cdntinker/KiCAD_Customs/3D/AG9912-MTB.stp

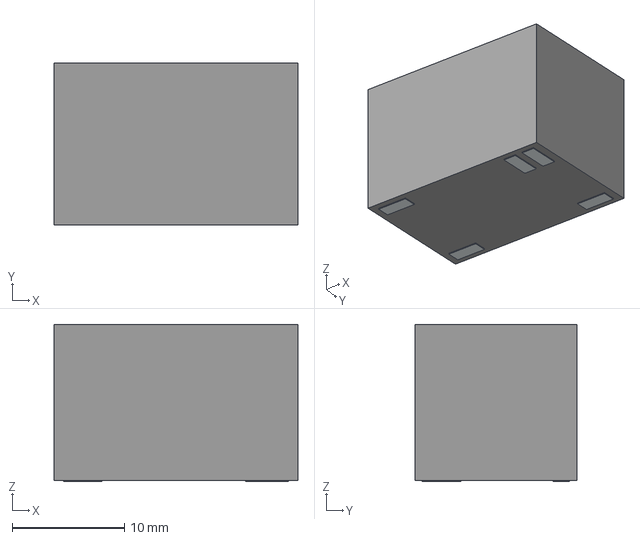
[picture p1: CAD file, 2023-11-06]
3D/AG9912-MTB.stp
21.7 x 14.4 x 14.0 mm
Pins
