cdntinker/KiCAD_Customs/3D/BM04B-SRSS-TB007_horizontal_qwiic.step

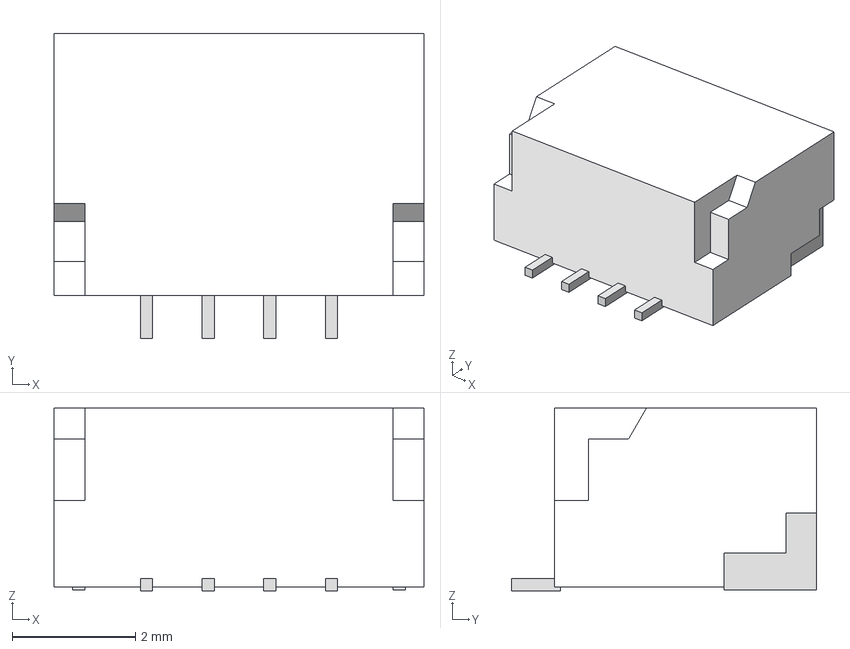
[picture p2: CAD file, 2023-11-06]
3D/BM04B-SRSS-TB007_horizontal_qwiic.step
6.00 x 4.95 x 2.96 mm
