cdntinker/KiCAD_Customs/3D/DMP3013SFV-7.stp

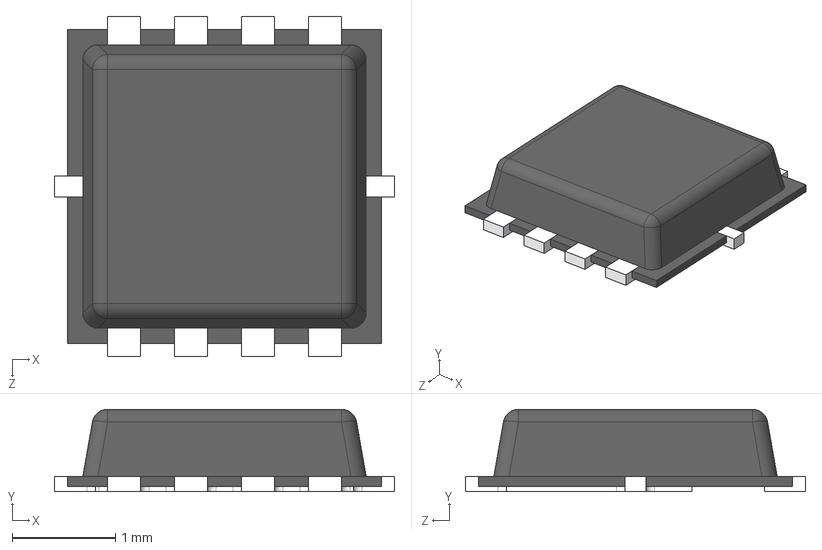
[picture p3: CAD file, 2023-11-06]
3D/DMP3013SFV-7.stp
3.30 x 0.8 x 3.30 mm
