cdntinker/KiCAD_Customs/3D/SCF4030-12-04.stp

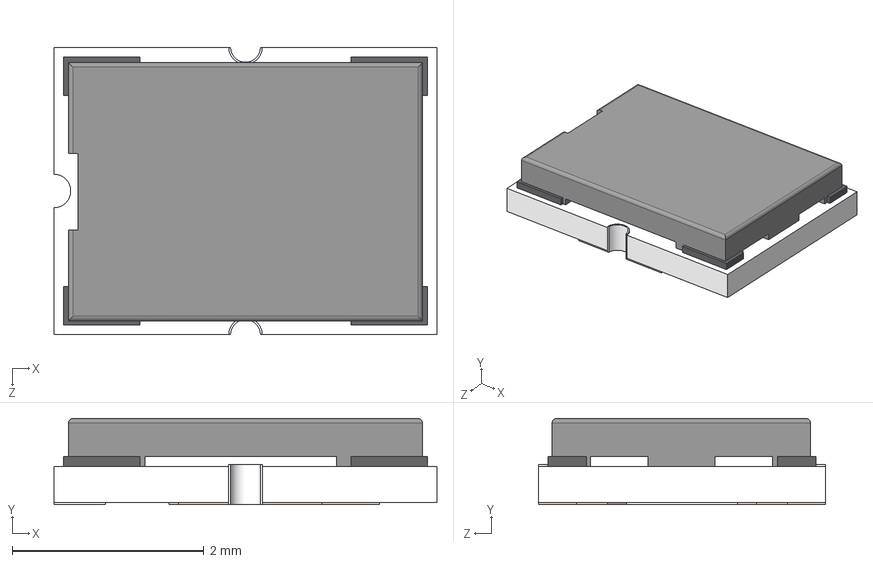
[picture p4: CAD file, 2023-11-06]
3D/SCF4030-12-04.stp
4.00 x 0.9 x 3.00 mm
奻裔
ｱｳｲｿｺｸﾅﾌ
價啣陔
籵謂1
ｱｳｲｿｺｸﾅﾌ2
籵謂2
左右电极背面 (2)
窪蝶1
窪蝶2
窪蝶3
窪蝶4
