cdntinker/KiCAD_Customs/3D/AT24C04D-MAHM-E.stp

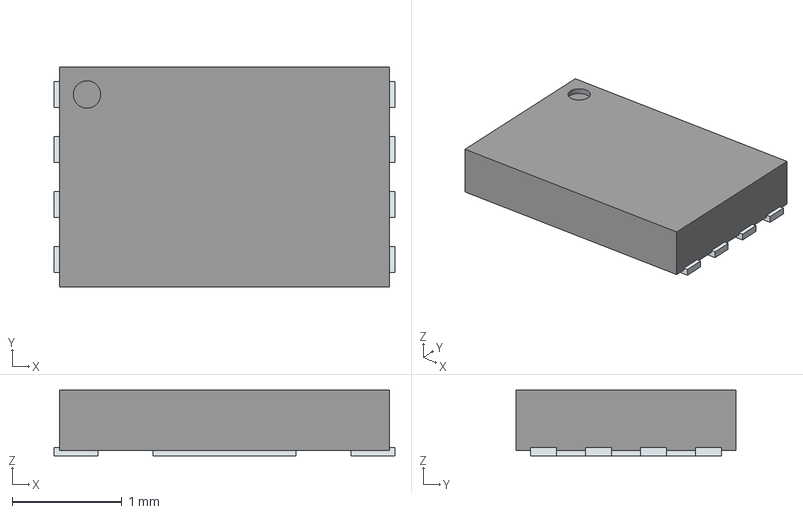
[picture p5: CAD file, 2023-11-06]
3D/AT24C04D-MAHM-E.stp
3.10 x 2.00 x 0.6 mm
ThermalPin
PinsArrayLR
