cdntinker/KiCAD_Customs/3D/USB4640-HZH-03.stp

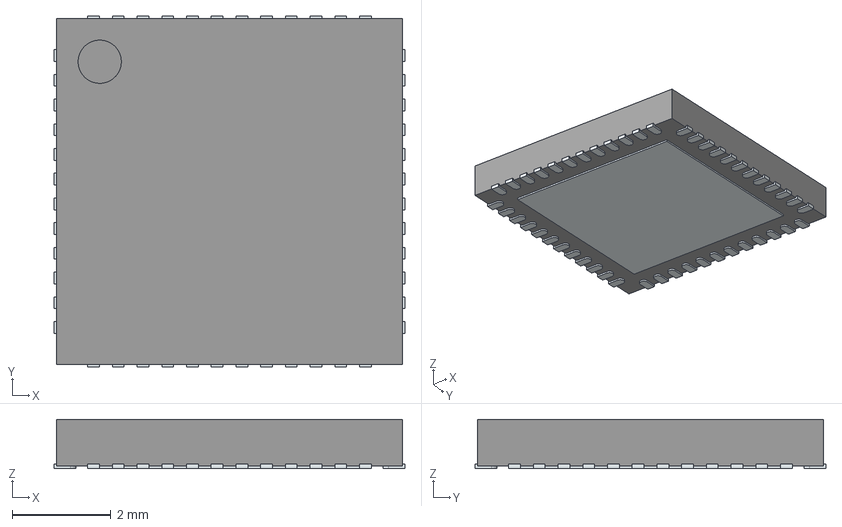
[picture p6: CAD file, 2023-11-06]
3D/USB4640-HZH-03.stp
7.10 x 7.10 x 1.00 mm
ThermalPin
PinsArrayLR
PinsArrayTB
