cdntinker/KiCAD_Customs/3D/1x2.STEP

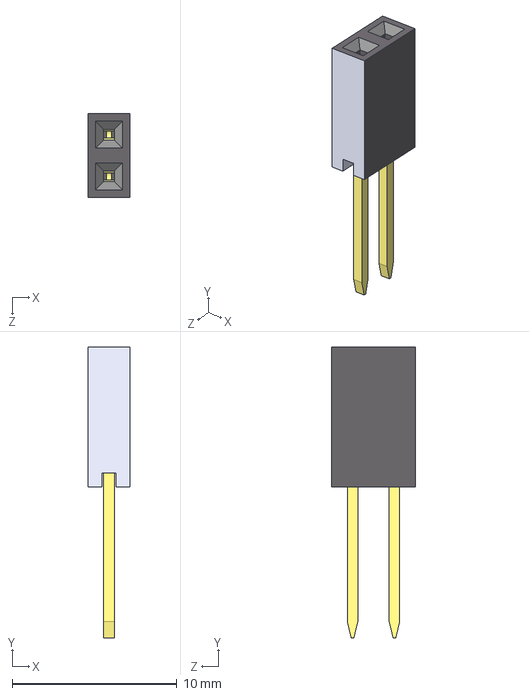
[picture p7: CAD file, 2023-11-06]
3D/1x2.STEP
2.54 x 17.6 x 5.08 mm
