cdntinker/KiCAD_Customs/3D/MicroSD_503398-1892.stp

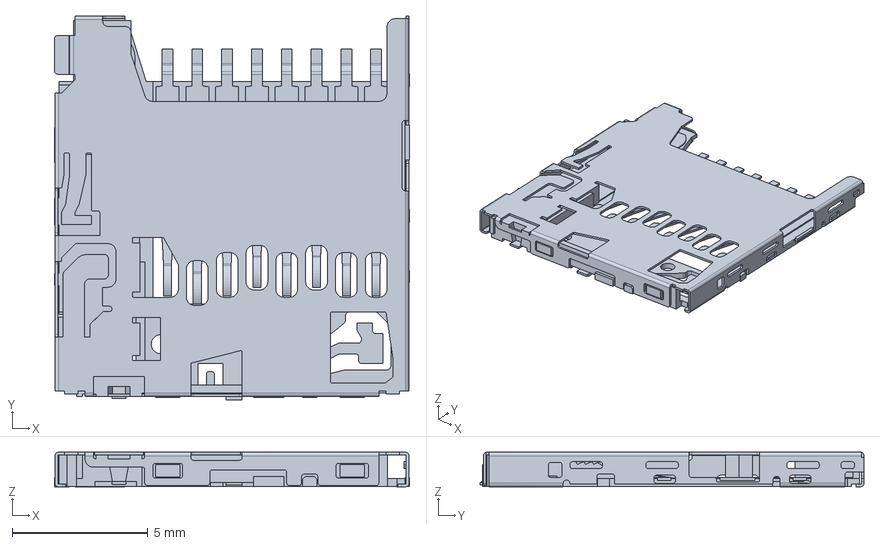
[picture p8: CAD file, 2023-11-06]
3D/MicroSD_503398-1892.stp
13.1 x 14.2 x 1.28 mm
