cdntinker/KiCAD_Customs/3D/SPM6530T-1R0M120.stp

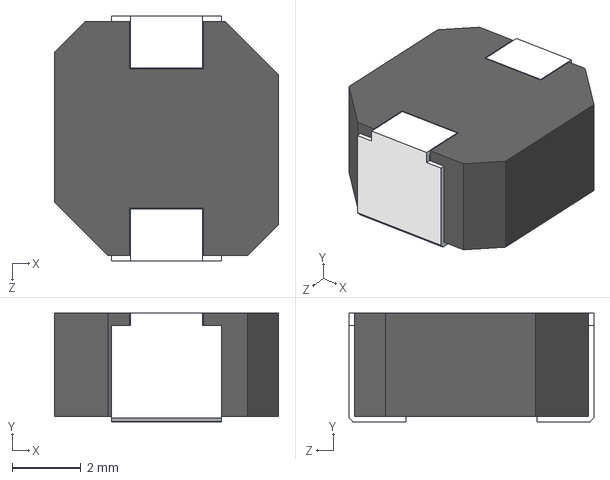
[picture p9: CAD file, 2023-11-06]
3D/SPM6530T-1R0M120.stp
6.50 x 3.15 x 7.10 mm
