cdntinker/KiCAD_Customs/3D/ARJM11D7114ABEW2.step

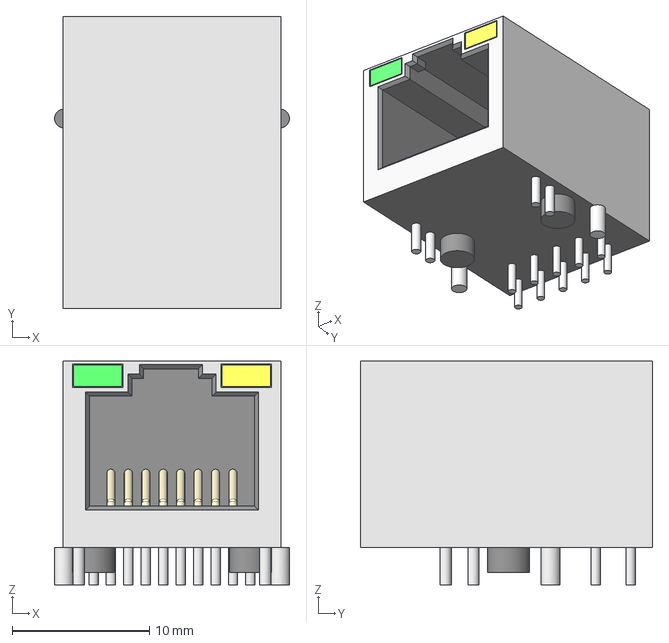
[picture p10: CAD file, 2023-11-06]
3D/ARJM11D7114ABEW2.step
17.1 x 21.3 x 16.3 mm
