cdntinker/KiCAD_Customs/3D/RQM0029A.stp

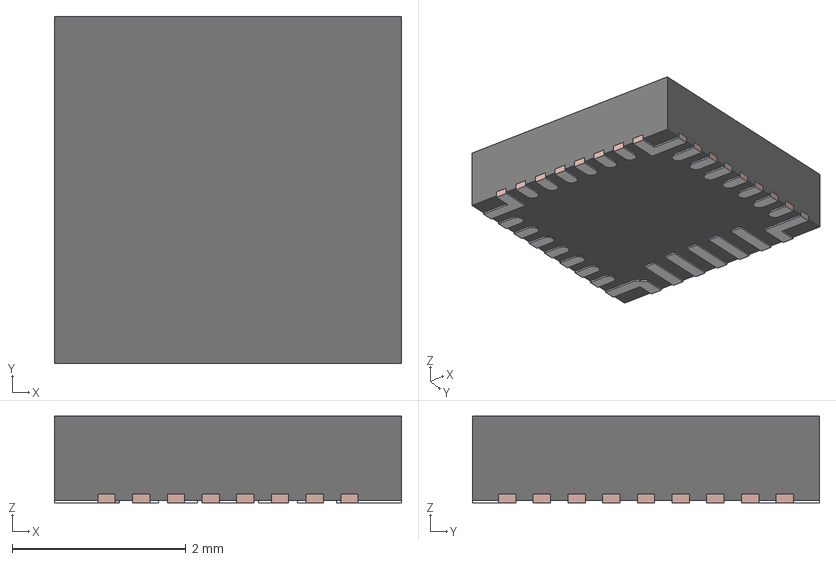
[picture p11: CAD file, 2023-11-06]
3D/RQM0029A.stp
4.00 x 4.00 x 1.00 mm
FRAME
MOLD
