cdntinker/KiCAD_Customs/3D/ABM8-26.000MHZ-10-1-U-T.STEP

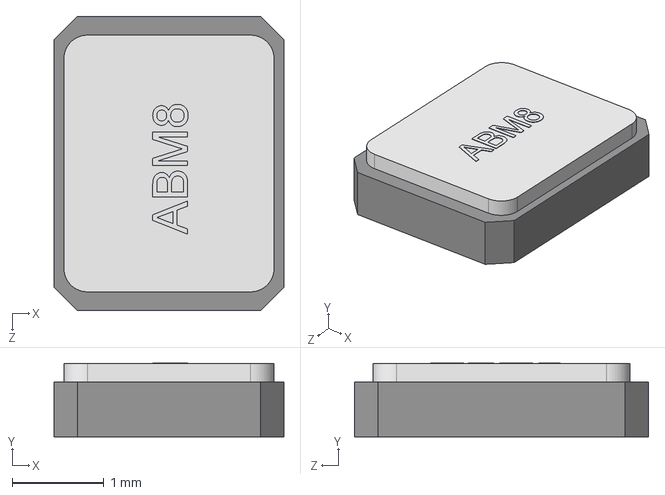
[picture p12: CAD file, 2023-11-06]
3D/ABM8-26.000MHZ-10-1-U-T.STEP
2.50 x 0.805 x 3.20 mm
