cdntinker/KiCAD_Customs/3D/QWIIC_Vertical-JST_SH_BM04B-SRSS-TB_1x04-1MP_P1.00mm_Vertical.step

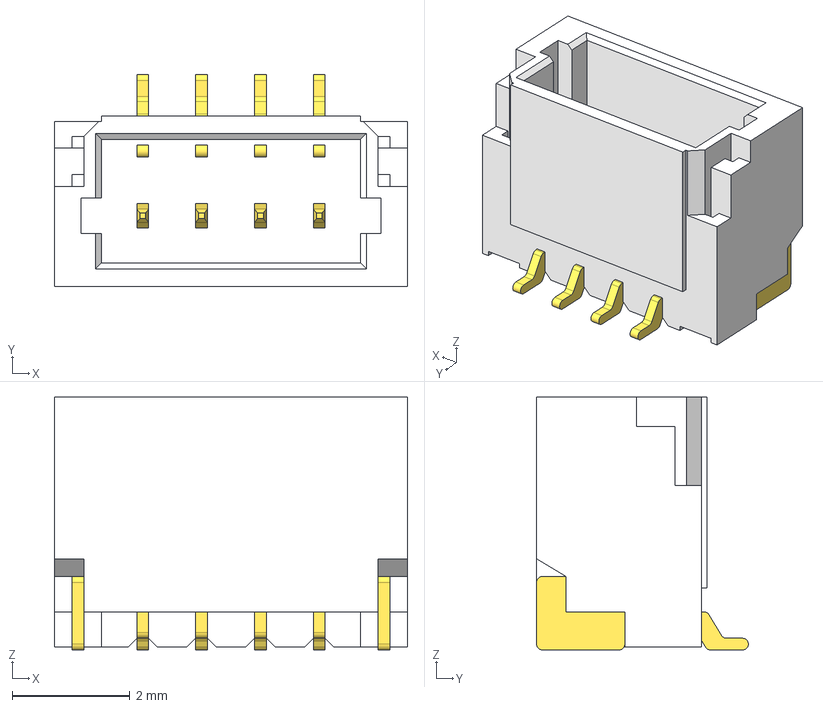
[picture p13: CAD file, 2023-11-06]
3D/QWIIC_Vertical-JST_SH_BM04B-SRSS-TB_1x04-1MP_P1.00mm_Vertical.step
6.00 x 3.60 x 4.30 mm
pin000
pin001
pin002
pin003
gnd000
gnd001
