cdntinker/KiCAD_Customs/3D/ESP8285.stp

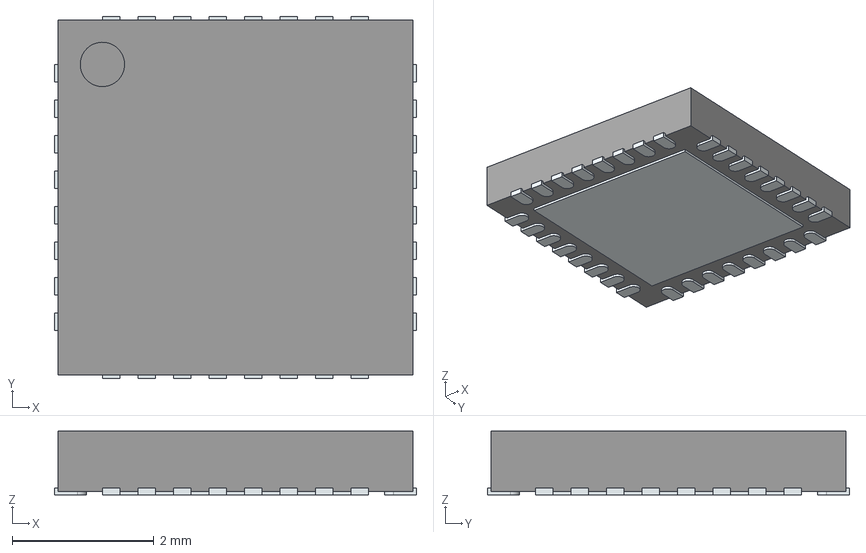
[picture p14: CAD file, 2023-11-06]
3D/ESP8285.stp
5.10 x 5.10 x 0.9 mm
ThermalPin
PinsArrayLR
PinsArrayTB
