cdntinker/KiCAD_Customs/3D/SISF06DN-T1-GE3.stp

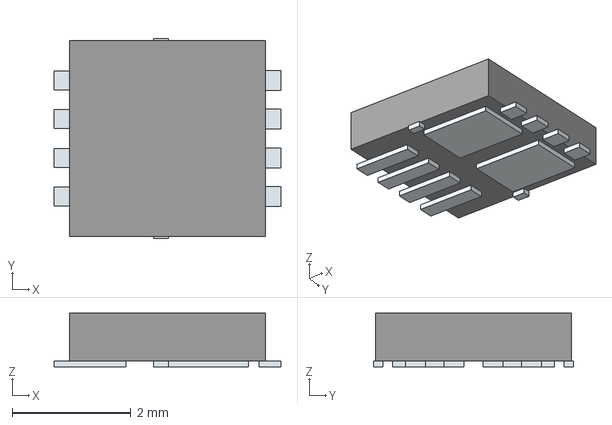
[picture p15: CAD file, 2023-11-06]
3D/SISF06DN-T1-GE3.stp
3.82 x 3.37 x 0.9 mm
Pins
