cdntinker/KiCAD_Customs/3D/Ag9912LP.stp

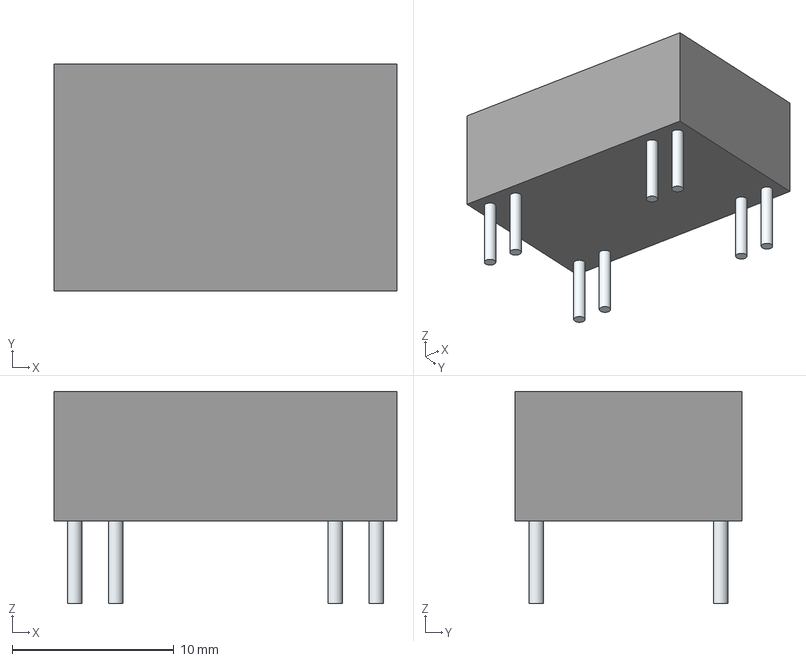
[picture p16: CAD file, 2023-11-06]
3D/Ag9912LP.stp
21.2 x 14.0 x 13.1 mm
Leads
