cdntinker/KiCAD_Customs/3D/XRCGB24_MUR.step

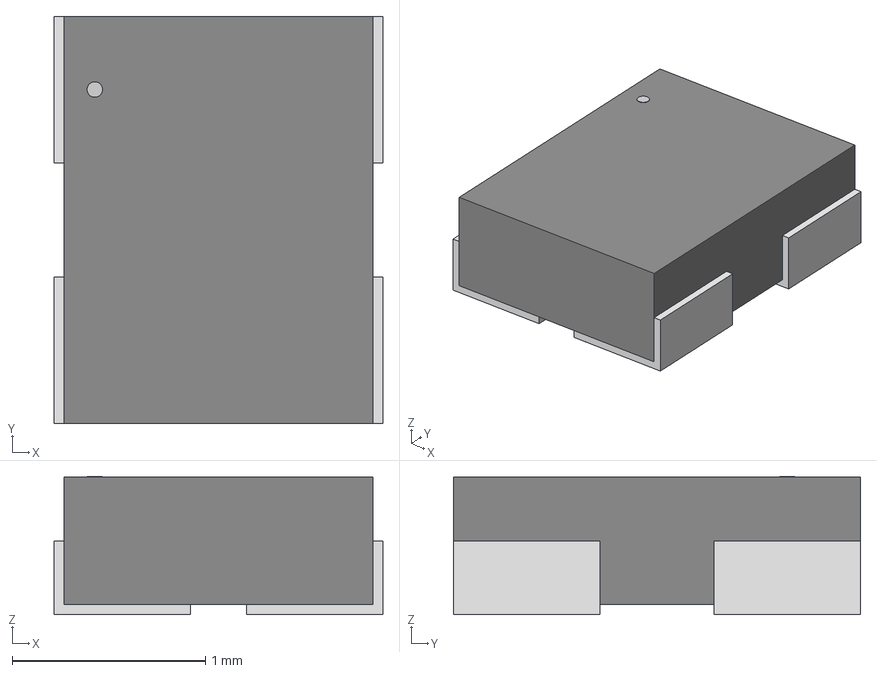
[picture p17: CAD file, 2023-11-06]
3D/XRCGB24_MUR.step
1.70 x 2.11 x 0.714 mm
