cdntinker/KiCAD_Customs/3D/1x4.STEP

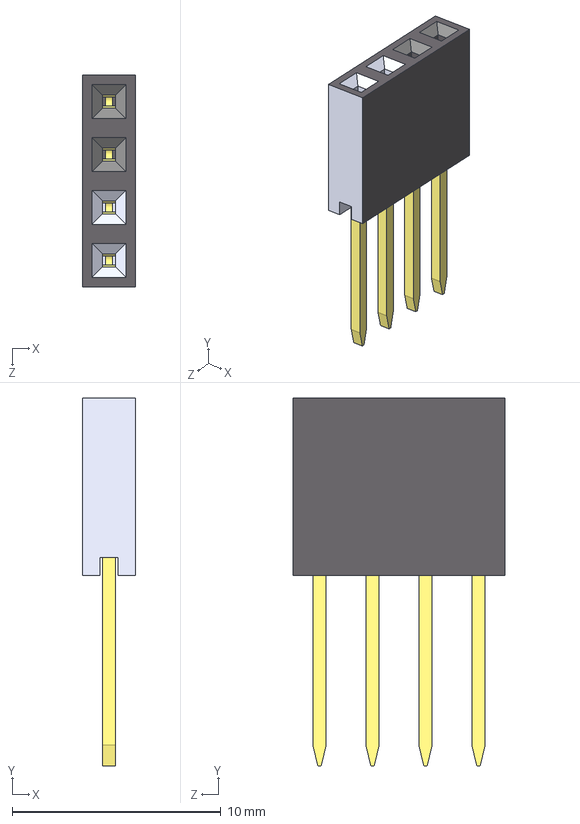
[picture p18: CAD file, 2023-11-06]
3D/1x4.STEP
2.54 x 17.6 x 10.2 mm
