cdntinker/KiCAD_Customs/3D/TPS2550DBVTG4.stp

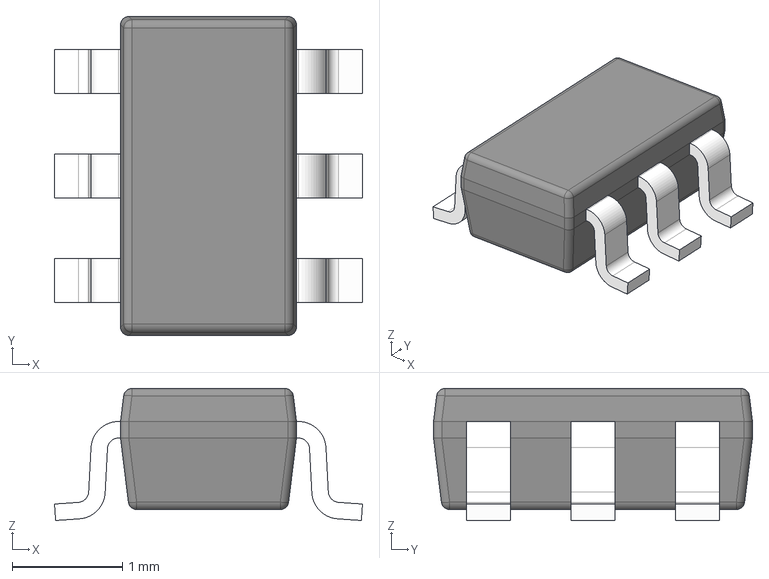
[picture p19: CAD file, 2023-11-06]
3D/TPS2550DBVTG4.stp
2.80 x 2.90 x 1.20 mm
BODY-SOT
LEAD-SOT x 6
