cdntinker/KiCAD_Customs/3D/EXC-3BP121H.stp

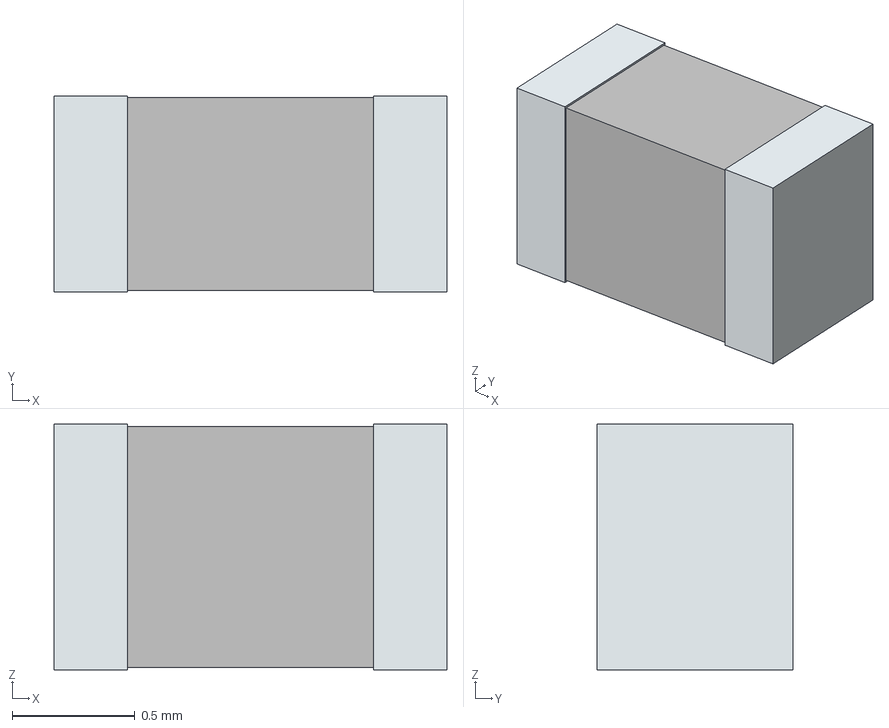
[picture p20: CAD file, 2023-11-06]
3D/EXC-3BP121H.stp
1.60 x 0.8 x 1.00 mm
term1
term2
