cdntinker/KiCAD_Customs/3D/Ag9900LP.step

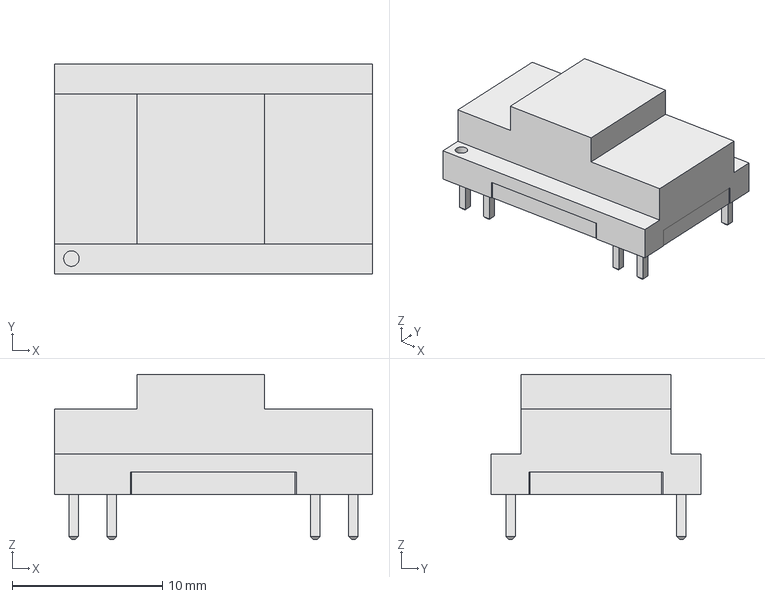
[picture p21: CAD file, 2023-11-06]
3D/Ag9900LP.step
21.2 x 14.0 x 11.0 mm
