cdntinker/KiCAD_Customs/3D/W25Q32JVXGIQ_TR.stp

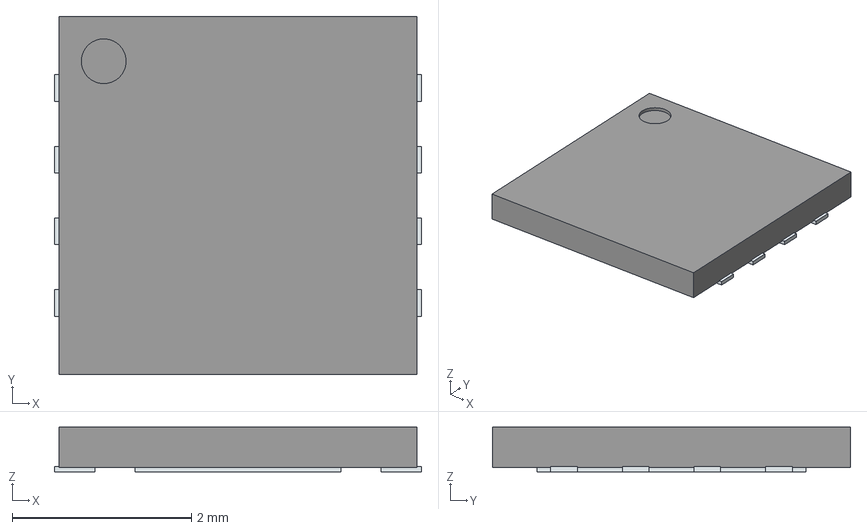
[picture p22: CAD file, 2023-11-06]
3D/W25Q32JVXGIQ_TR.stp
4.10 x 4.00 x 0.5 mm
ThermalPin
PinsArrayLR
