cdntinker/KiCAD_Customs/3D/WS2812B.step

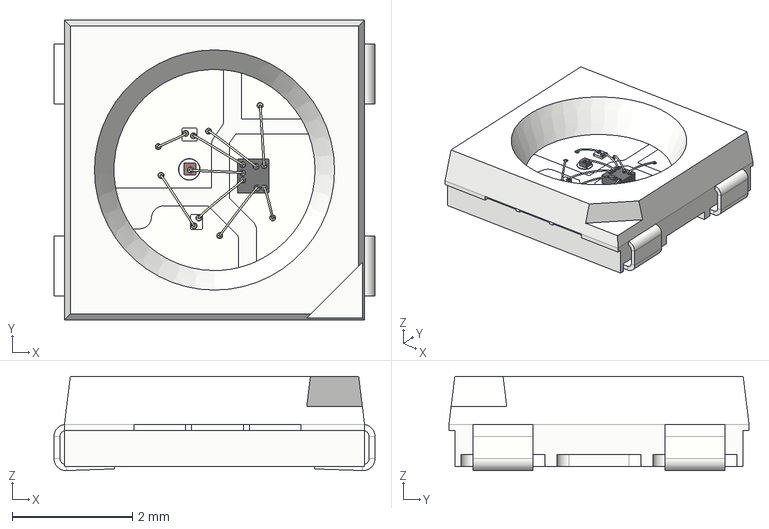
[picture p23: CAD file, 2023-11-06]
3D/WS2812B.step
5.35 x 5.00 x 1.57 mm
