cdntinker/KiCAD_Customs/3D/BM04B-SRSS-TB.STEP

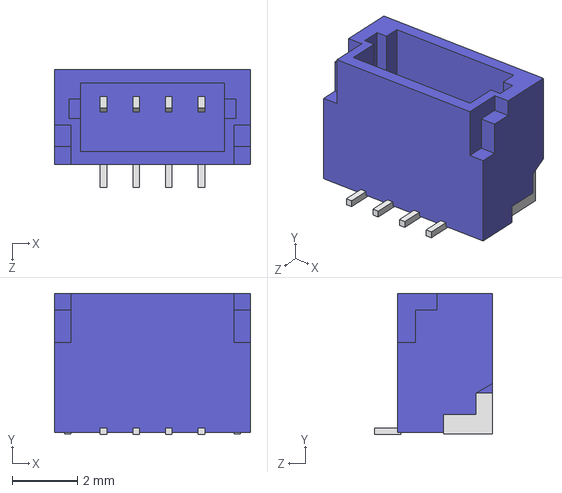
[picture p24: CAD file, 2023-11-06]
3D/BM04B-SRSS-TB.STEP
6.00 x 4.32 x 3.60 mm
