cdntinker/KiCAD_Customs/3D/TF-01A-microSD.stp

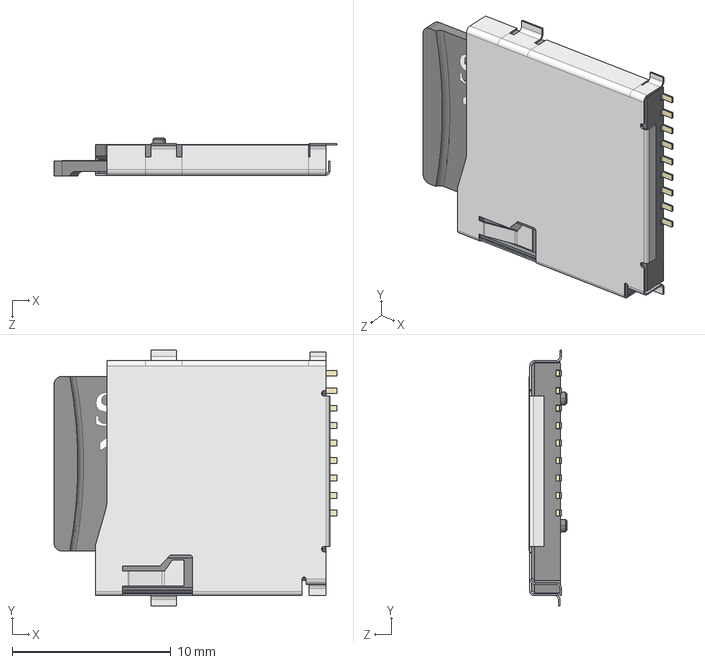
[picture p25: CAD file, 2023-11-06]
3D/TF-01A-microSD.stp
17.8 x 16.1 x 2.40 mm
