cdntinker/KiCAD_Customs/3D/ASE-48.000MHZ-C-T3.STEP

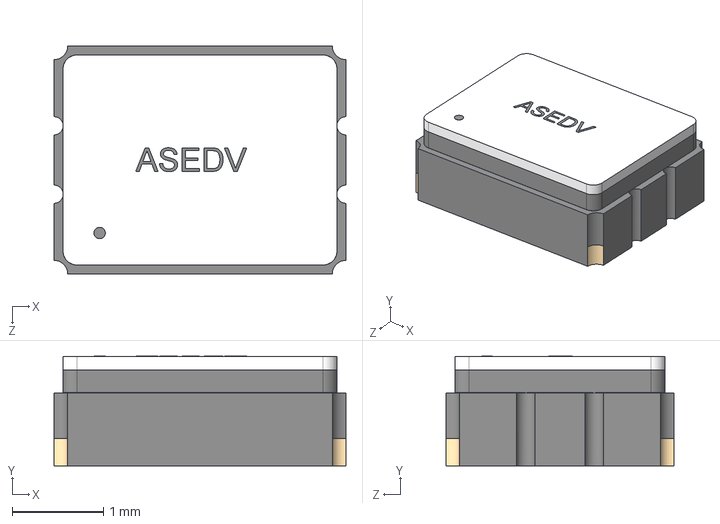
[picture p26: CAD file, 2023-11-06]
3D/ASE-48.000MHZ-C-T3.STEP
3.20 x 1.20 x 2.50 mm
