cdntinker/KiCAD_Customs/3D/Wuerth_692112030100.stp

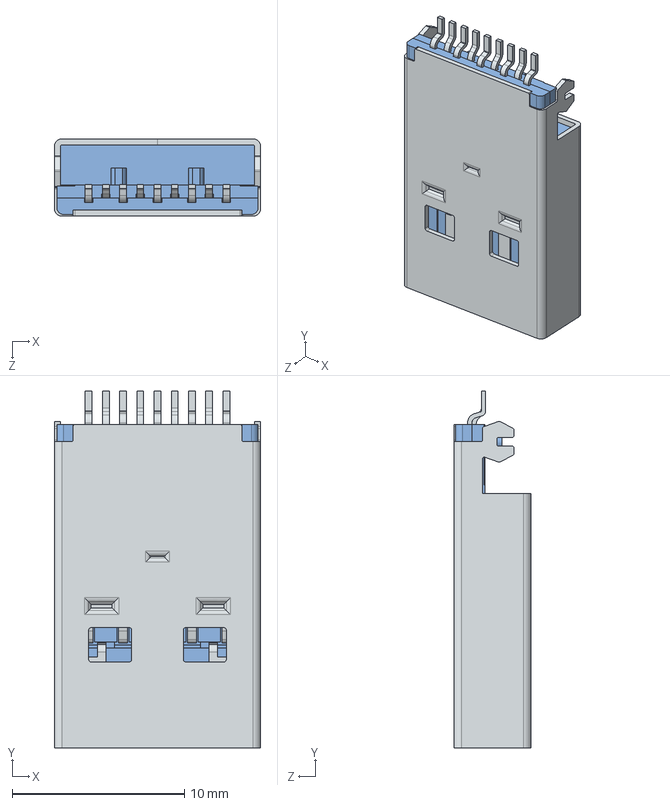
[picture p27: CAD file, 2023-11-06]
3D/Wuerth_692112030100.stp
12.0 x 20.8 x 4.50 mm
