cdntinker/KiCAD_Customs/3D/A-USB-A-SMT.stp

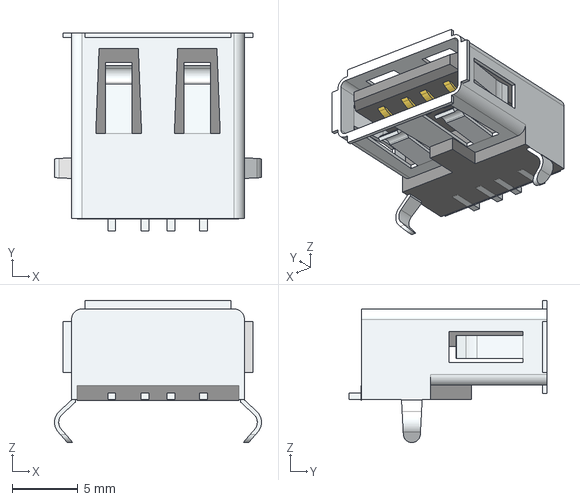
[picture p28: CAD file, 2023-11-06]
3D/A-USB-A-SMT.stp
15.8 x 15.1 x 10.8 mm
