cdntinker/KiCAD_Customs/3D/AG9912M.stp

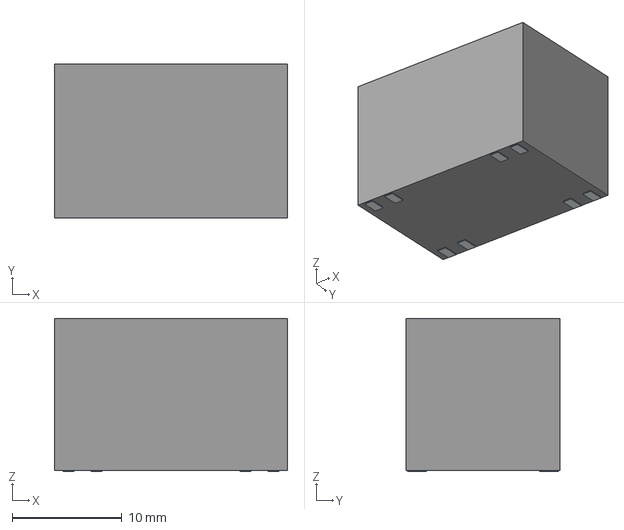
[picture p30: CAD file, 2023-11-06]
3D/AG9912M.stp
21.2 x 14.0 x 13.9 mm
Pins
