cdntinker/KiCAD_Customs/3D/Wuerth_692122030100.stp

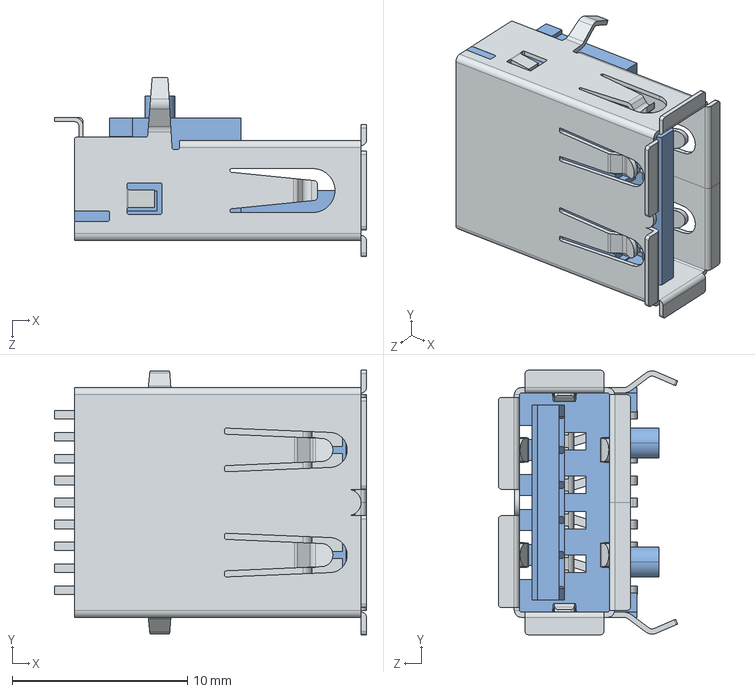
[picture p31: CAD file, 2023-11-06]
3D/Wuerth_692122030100.stp
17.8 x 15.1 x 10.2 mm
