cdntinker/KiCAD_Customs/3D/USB2660I-JZX-03.stp

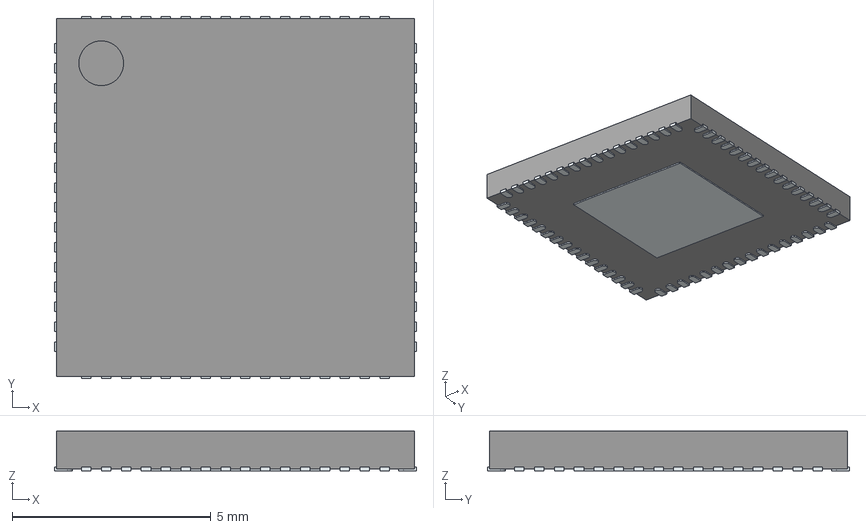
[picture p32: CAD file, 2023-11-06]
3D/USB2660I-JZX-03.stp
9.10 x 9.10 x 1.00 mm
ThermalPin
PinsArrayLR
PinsArrayTB
