cdntinker/KiCAD_Customs/3D/USB Connector Type A male, SMT.STEP

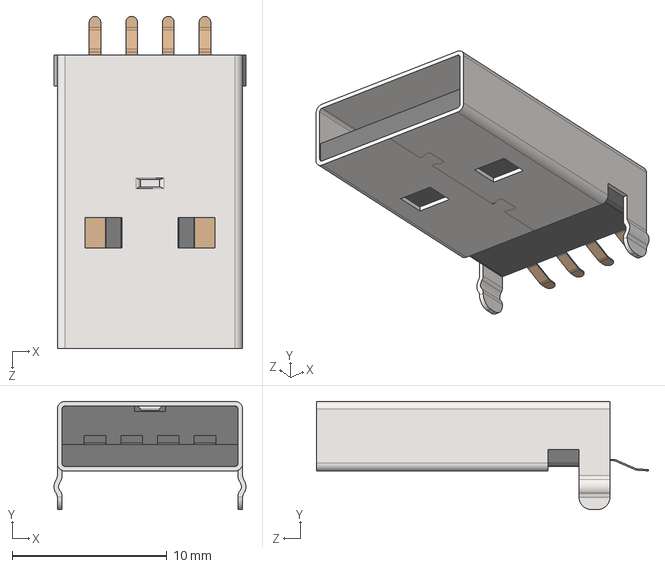
[picture p33: CAD file, 2023-11-06]
3D/USB Connector Type A male, SMT.STEP
12.4 x 7.00 x 21.5 mm
