cdntinker/KiCAD_Customs/(list of files, cad)

Other CAD files:
3D/QWIIC_Horizontal-JST_SH_SM04B-SRSS-TB_1x04-1MP_P1.step
3D/USB2642_ML.stp
3D/BM04B-SRSS-TB007_vertical_qwiic.step
3D/PGB1010603NR.stp
